bperez77/embedded-snake-game-18348/README.md

# snakeGame
Implements a simple snake game on embedded hardware. Specifically, the game is implemented on a LED array that is driven by an MC9S12C128 Freescale module.
