bperez77/embedded-snake-game-18348/doc/circuitSchematic.pdf

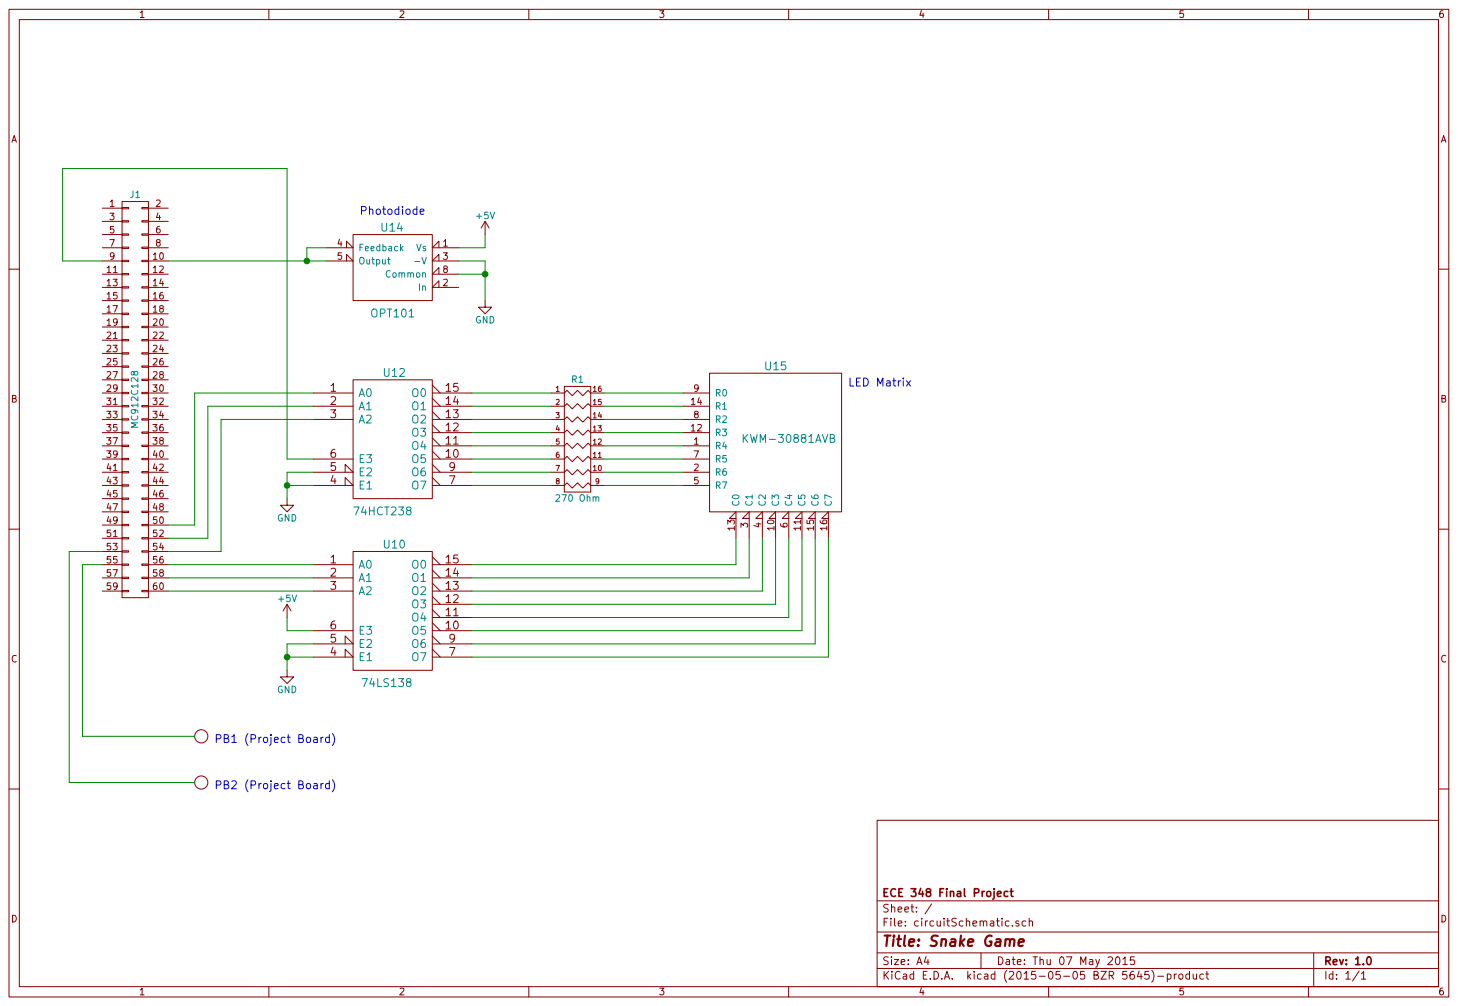
[picture p3: page 1]

LED Matrix PB1 (Project Board)

Id: 1/1 Title: Snake Game
