bperez77/embedded-snake-game-18348/doc/circuitSchematic/circuitSchematic.sch

## KiCad design doc/circuitSchematic/circuitSchematic.sch (2015-05-14)

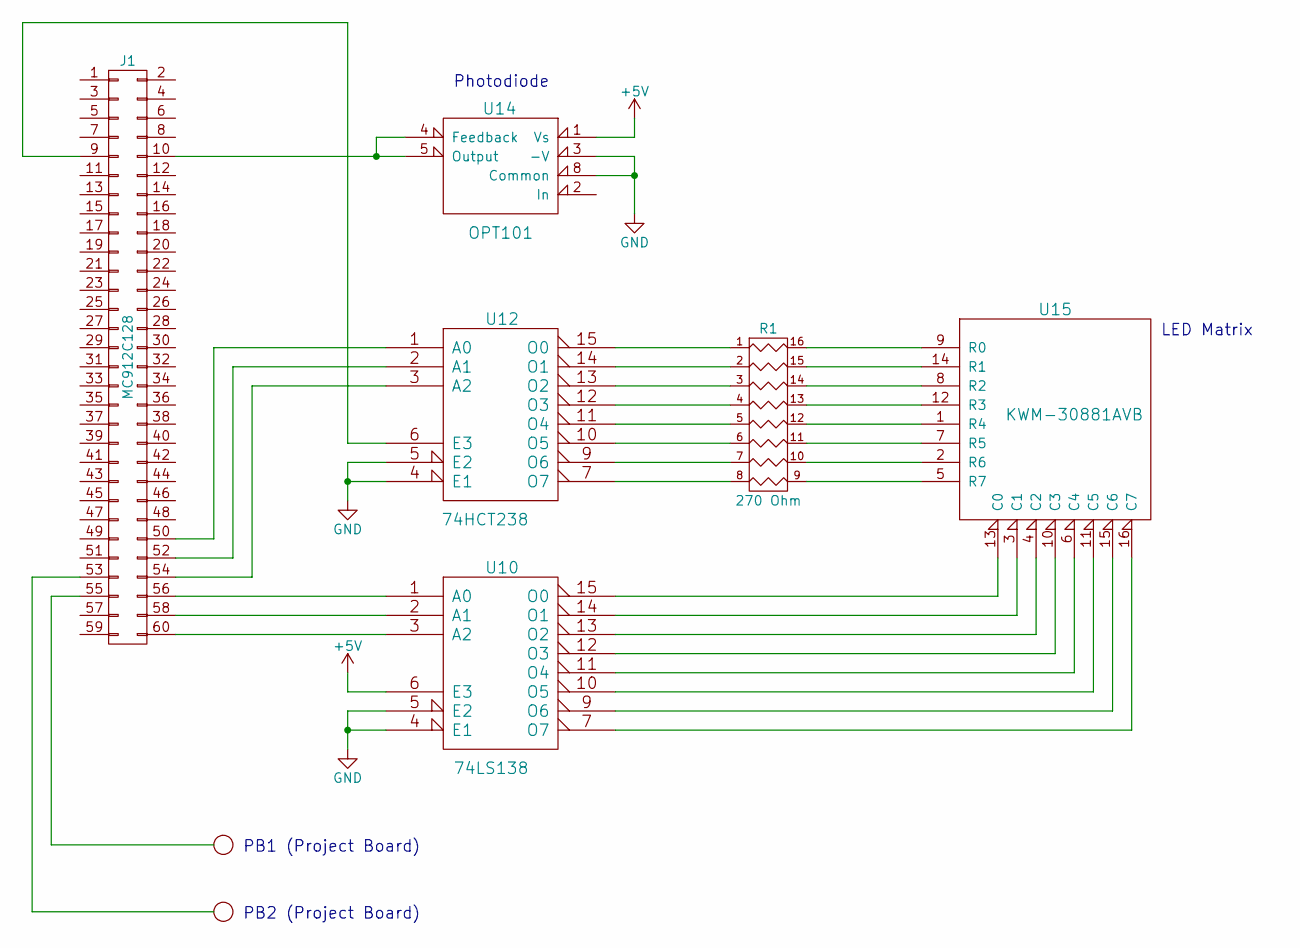
[picture p4: schematic circuitSchematic.sch]

Parts:
J1: MC912C128
R1: 270 Ohm
U10: 74LS138
U12: 74HCT238
U14: OPT101
U15: KWM-30881AVB

Connections:
+5V: U10.6 (E3), U14.1 (Vs)
GND: U10.4 (E1), U10.5 (E2), U12.4 (E1), U12.5 (E2), U14.3 (-V), U14.8 (Common)
unnamed: J1.9, U12.6 (E3)
unnamed: J1.10, U14.4 (Feedback), U14.5 (Output)
unnamed: J1.50, U12.1 (A0)
unnamed: J1.52, U12.2 (A1)
unnamed: J1.54, U12.3 (A2)
unnamed: J1.56, U10.1 (A0)
unnamed: J1.58, U10.2 (A1)
unnamed: J1.60, U10.3 (A2)
unnamed: R1.1, U12.15 (O0)
unnamed: R1.2, U12.14 (O1)
unnamed: R1.3, U12.13 (O2)
unnamed: R1.4, U12.12 (O3)
unnamed: R1.5, U12.11 (O4)
unnamed: R1.6, U12.10 (O5)
unnamed: R1.7, U12.9 (O6)
unnamed: R1.8, U12.7 (O7)
unnamed: R1.9 (R8), U15.5 (R7)
unnamed: R1.10 (R7), U15.2 (R6)
unnamed: R1.11 (R6), U15.7 (R5)
unnamed: R1.12 (R5), U15.1 (R4)
unnamed: R1.13 (R4), U15.12 (R3)
unnamed: R1.14 (R3), U15.8 (R2)
unnamed: R1.15 (R2), U15.14 (R1)
unnamed: R1.16 (R1), U15.9 (R0)
unnamed: U10.7 (O7), U15.16 (C7)
unnamed: U10.9 (O6), U15.15 (C6)
unnamed: U10.10 (O5), U15.11 (C5)
unnamed: U10.11 (O4), U15.6 (C4)
unnamed: U10.12 (O3), U15.10 (C3)
unnamed: U10.13 (O2), U15.4 (C2)
unnamed: U10.14 (O1), U15.3 (C1)
unnamed: U10.15 (O0), U15.13 (C0)

Notes on the sheet:
LED Matrix
PB1 (Project Board)
PB2 (Project Board)
Photodiode
