bperez77/embedded-snake-game-18348/inc/bit_help.h

/* bit_help.h
 *
 * ECE348, Spring 2015
 * Group C4
 * Brandon Perez bmperez
 * Rohit Banerjee rohitban
 *
 * Target: MC9S12C128
 * CodeWarrior Version: 5.1
 *
 * Created: Sun 26 Apr 2015 06:16:55 PM EDT
 * Last Modified: Thu 07 May 2015 08:42:12 PM EDT
 *
 * This file contains the interface for the bit help module, which is a
 * helper module for performing bit-wise operations (generating bit masks,
 * set bits of a number, etc.).
 */

#ifndef BIT_HELP_H_
#define BIT_HELP_H_

#include "stdint.h"

/* mask_below
 *
 * Generates a mask that masks out the bits below and including bit_pos,
 * [bit_pos:0], in an 8-bit number. Bit_pos must be between 7 and 0.
 */
uint8_t mask_below(int8_t bit_pos);

/* mask_above
 *
 * Generates a mask that masks out the bits above and including bit_pos,
 * [7:bit_pos], in an 8-bit number. Bit_pos must be between 7 and 0.
 */
uint8_t mask_above(int8_t bit_pos);

/* mask_between
 *
 * Generates a mask that that masks out the bits between lower and upper,
 * inclusive [upper:lower], in an 8-bit number. Lower and upper must be
 * between 7 and 0.
 */
uint8_t mask_between(int8_t lower, int8_t upper);

/* extract_bits
 *
 * Extracts the bits from position lower to upper, inclusive x[upper:lower].
 * Lower and upper must both be between 7 and 0.
 *
 */
uint8_t extract_bits(uint8_t x, int8_t lower, int8_t upper);

/* set_bits
 *
 * Sets the bits from position lower to upper, x[upper:lower], with the lower
 * (upper - lower) bits of y. The rest of the bits of x are preserved. If
 * any other bits of y are set, then the result is undefined. Lower and upper
 * must both be between 7 and 0.
 */
uint8_t set_bits(uint8_t x, uint8_t y, int8_t lower, int8_t upper);

/* mod_8
 *
 * Computes x % limit. Limit must be a power of 2. The modulo computed
 * is strictly non-negative. This function is for 8-bit types.
 */
uint8_t mod_8(uint8_t x, uint8_t limit);

/* mod_16
 *
 * Computes x % limit. Limit must be a power of 2. The modulo computed
 * is strictly non-negative. This function is for 16-bit types.
 */
uint16_t mod_16(uint16_t x, uint16_t limit);

#endif /* BIT_HELP_H_ */
