bperez77/embedded-snake-game-18348/(commit log)

2015-04-24 The tables used to build the design pdf.
    [q4.csv, q5.csv, q7.1.1.csv, q7.1.2.csv, q7.2.1.csv, q7.2.2.csv]
2015-04-25 The module responsible for managing all of the proper settings on the MC9S12C128 module and project board.
2015-04-26 Moved header files to inc directory, and source files to the src directory. Added in all the proper setting for initilaizing the module on the board in setup.c.
2015-04-26 Added in documentation and the pin connections.
2015-04-26 Implemented the timer interrupt, which updates the game state, and draws the LED matrix.
2015-04-26 Implemented the serial and A/D interrupts.
2015-04-27 Implemented the main loop task for the project. Reads the button inputs, and prints the score and A/D value out to the LCD screen.
2015-04-27 Added in unit tests for the snake game. All the tests were passed. Fixed syntax errors.
    [bit_help.h, snake_game.c, stdint.h]
2015-04-27 Fixed syntax errors in the rest of files, now compilable with CodeWarrior.
    [bit_help.c, bit_help.h, main.c, setup.c, setup.h, snake_game.c, stdbool.h]
2015-04-28 Fixed a bug where the select line for the row was inverted due to a misconception.
    [main.c]
2015-04-28 Added watchdog setup and interrupt
2015-04-29 Normalized spaces and tabs, and some fixup documentation.
    [main.c, setup.c, setup.h]
2015-04-29 Enabled the timer in Wait Mode, which is not relevant to BDM (background debug mode).
2015-04-30 Changed the method by which LED's are drawn. Instead of drawing LED's one at time, entire frames are drawn on each timer interrupt. The frequency corresponds to the Persistence of Vision (POV).
2015-04-30 Fixed the setup of Port AD (brightness analog input), and changed the A/D input string on the LCD to fit on the line.
    [main.c, setup.c]
2015-04-30 Fixed a bug where the analog value was sampled from Port AD[0], when it should have been sampled from Port AD[7].
    [setup.c]
2015-04-30 Fixed the watchdog timer to block whenever it is tripped. Added in a forgotten EnableInterrupts. Removed the Serial Task from the watchdog tasks, as it is dependent upon user input, which can take ar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
    [main.c]
2015-04-30 Setup the snake movement so that only occurs every 250 ms now, by moving the snake only so many timer interrupts.
2015-05-02 Fixed the serial interrupt. For some reason, the RDRF flag is already cleared upon entering the interrupt. Flipped the left and right commands to match the orientation of the LED matrix.
    [main.c]
2015-05-02 Added in latching for the button presses. Got the serial interrupt fully working. Turned off watchdog temporarily for debugging.
2015-05-02 Fixed the updating of the score, which lacked the needed volatile qualifier.
    [main.c]
2015-05-02 Made the direction commands case insensitive.
2015-05-03 Suppressed a compiler warning about a volatile type, and switched the directions to match the new wiring setup for the LED matrix.
2015-05-03 Changed the drawing of the LED's to the original scheme, driving one LED per timer interrupt. Adjusted the timing appropiately. Reduced the frequency of the ATD interrupt to the maximum period (least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
2015-05-08 Created a circuit schematic for the project's hardware.
    [circuitSchematic.sch]
2015-05-08 Added in the circuit libraries used for the project.
2015-05-08 Created a lab report for the project.
    [q5.csv, report_q1.2.csv, report_q3.1.csv, report_q3.2.csv, report_q3.3a.1.csv, report_q3.3a.2.csv, report_q3.3b.1.csv, report_q3.3b.2.csv]
2015-05-14 Added in the circuit schematic with resistors. Updated the kicad project appropiately.
    [circuitSchematic.sch]
2015-05-14 Moved all of the documentation files into doc. Updated the Makefile appropiately.
    [circuitSchematic.sch, q4.csv, q5.csv, q7.1.1.csv, q7.1.2.csv, q7.2.1.csv, q7.2.2.csv, report_q1.2.csv]
